rodriboye/PFI-localizacion-acustica/Extras/pin diagram - Raspberry Pi 3A+.jpeg

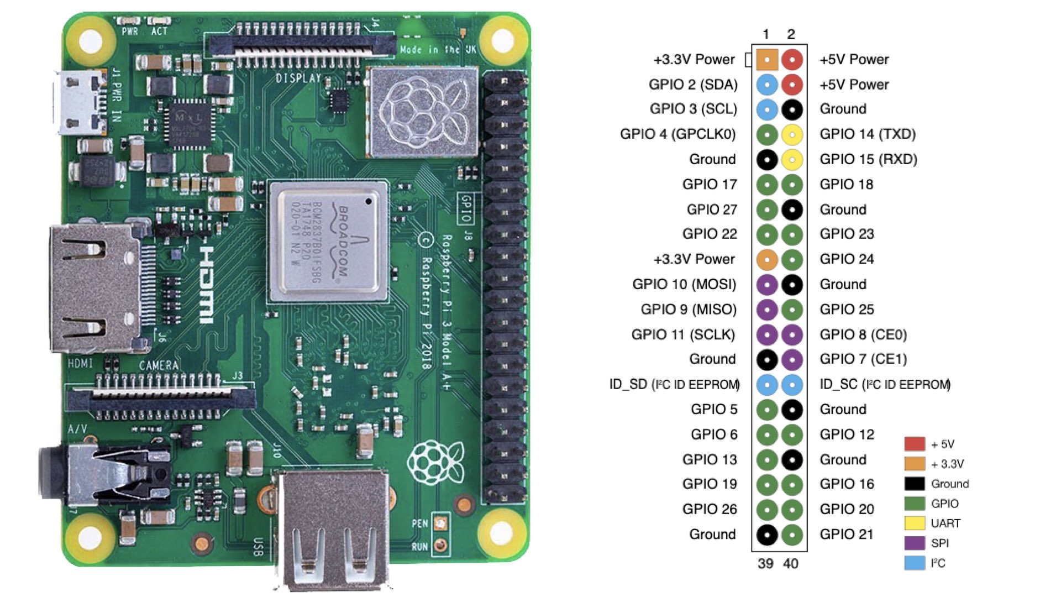
Extras/pin diagram - Raspberry Pi 3A+.jpeg
