rodriboye/PFI-localizacion-acustica/Planos/README.txt

Archivos JSON de EasyEDA, donde pueden ser editados y/o exportados como archivos GERBER, PDF, PNG o formatos de otros programas de diseño.

Para utilizarlos:

Desde [https://easyeda.com/editor], abrir el documento via: File -> Open -> EasyEDA... -> seleccionar el archivo json
