rodriboye/PFI-localizacion-acustica/Extras/Poster Presentación Invap Open Day/poster 1.png

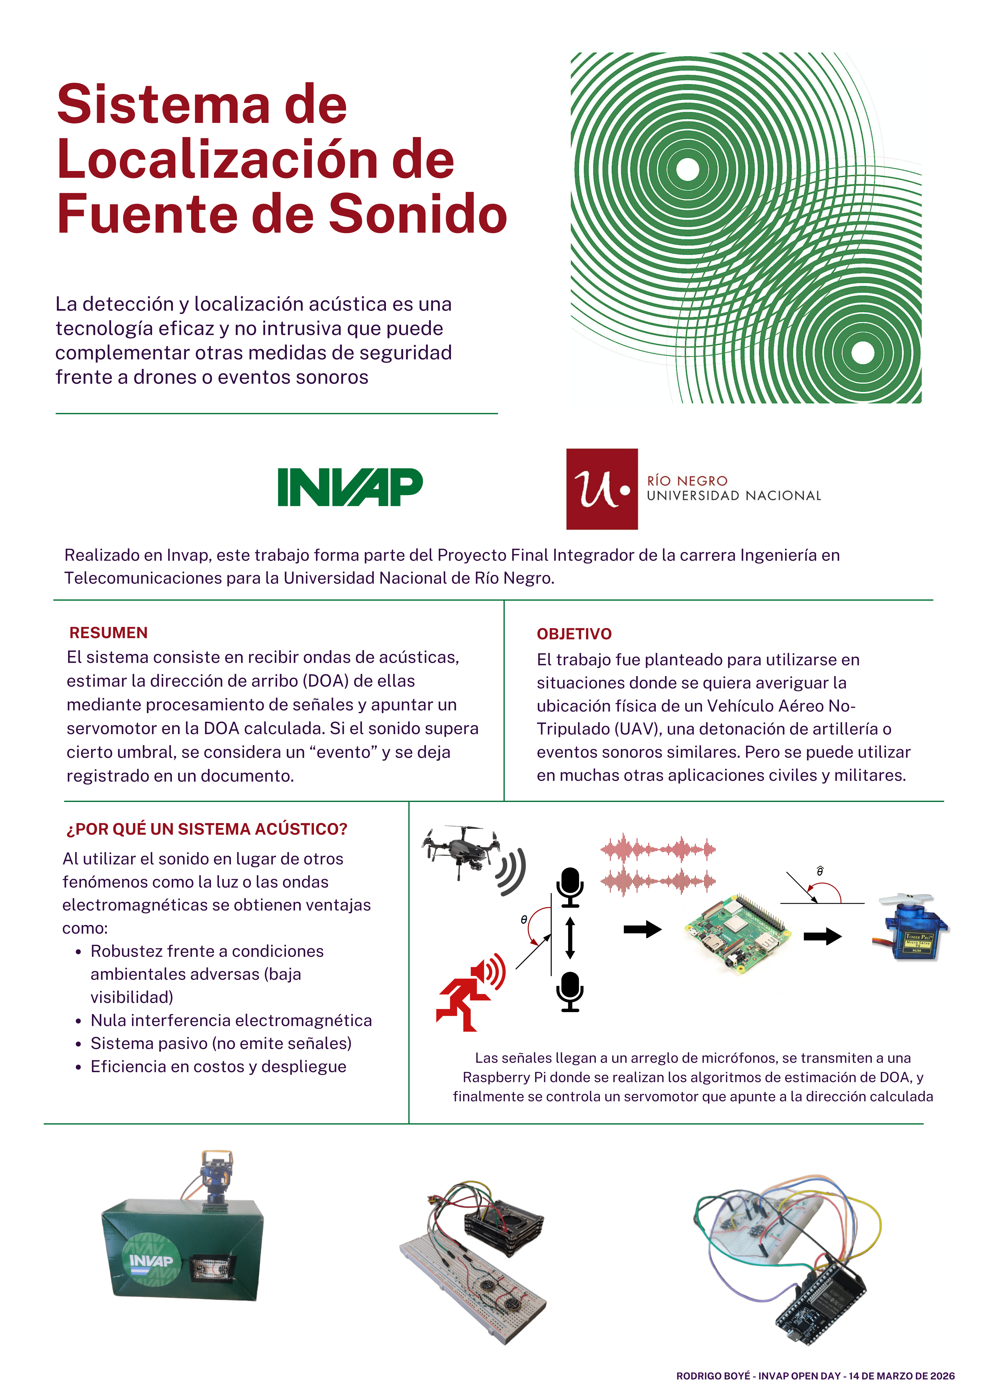
Extras/Poster Presentación Invap Open Day/poster 1.png
