rodriboye/PFI-localizacion-acustica/Extras/Poster Presentación Invap Open Day/poster 2.png

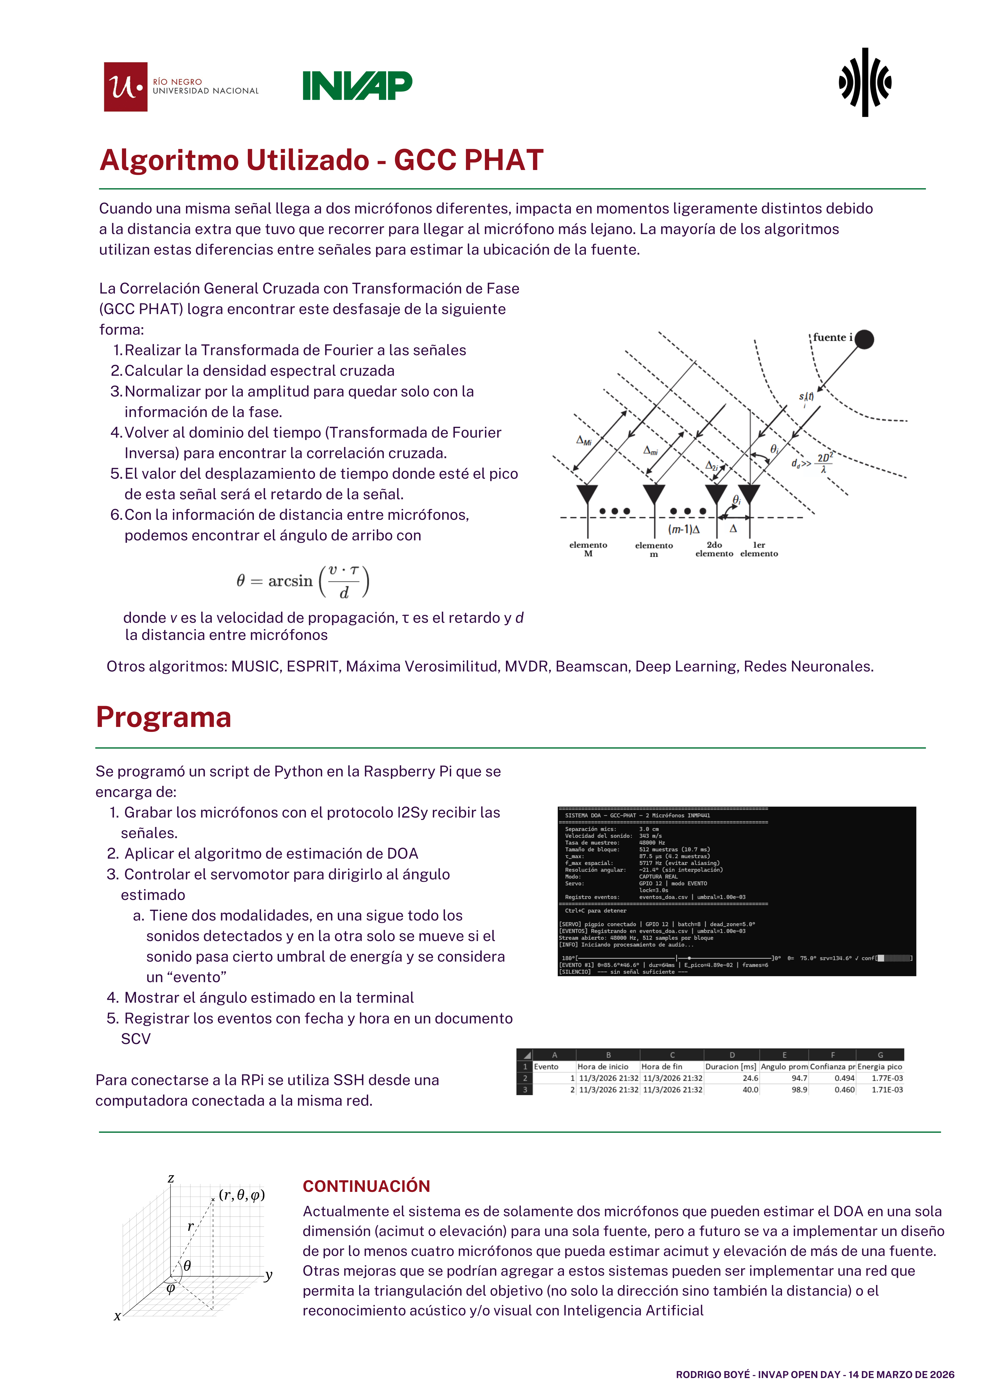
Extras/Poster Presentación Invap Open Day/poster 2.png
