rodriboye/PFI-localizacion-acustica/(list of files, drawings)

Other design files:
Planos/2mics/PCB - 2mics.json
Planos/2mics/Schematic - 2mics.json
Planos/4mics/PCB - 4mics 08x10cm.json
Planos/4mics/PCB - 4mics 10x15cm.json
Planos/4mics/Schematic - 4mics.json
